gfroerli/hardware/README.md

## PCB

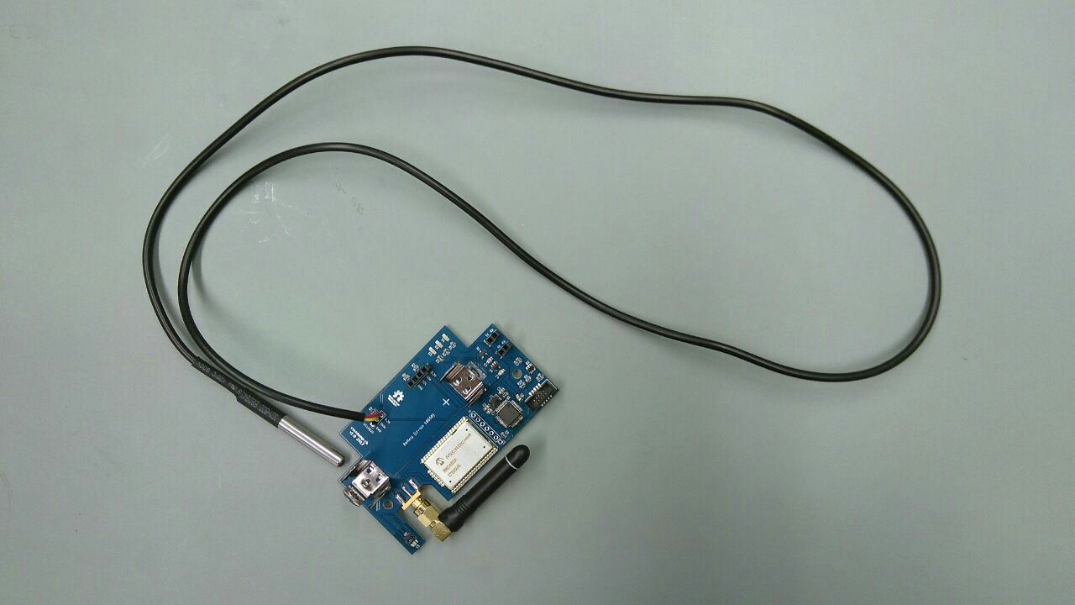
[picture p1: pcb.png]


## Datasheets

- Enclosure: http://www.produktinfo.conrad.com/datenblaetter/525000-549999/536028-da-01-de-GEHAEUSE_ABS_PICCOLO_ABS_B_65_G.pdf
