gfroerli/hardware/pcb/bom.ods

Designators | Value | Size | Digikey | Manufacturer | Quantity
C5,C6,C7 | 100nF | 0805 | 1276-6468-1-ND | CL21B104KBFNNNG | 3
C3,C4 | 1uF | 0805 | 1276-6471-1-ND | CL21B105KOFNNNG | 2
C1,C2 | 18pF | 0805 | 1276-1107-1-ND | CL21C180JBANNNC | 2
R1,R2,R3 | 470Ohm | 0805 | 311-470CRCT-ND | RC0805FR-07470RL | 3
R4,R5,R6,R7,R11,R12 | 10kOhm | 0805 | 311-10KARCT-ND | RC0805JR-0710KL | 6
R8 | 4.7kOhm | 0805 | 311-4.70KCRCT-ND | RC0805FR-074K7L | 1
R9 | 6.04kOhm |  | P20683CT-ND | ERJ-PB6B6041V | 1
R10 | 9.31kOhm |  | YAG2002CT-ND | RT0805BRD079K31L | 1
D1 | LED rot | 0805 | 475-1278-1-ND | LS R976-NR-1 | 1
D3 | LED grün | 0805 | 475-1410-1-ND | LG R971-KN-1 | 1
D2 | LED gelb | 0805 | 475-2560-1-ND | LY R976-PS-36 | 1
BT1 | Battery clips |  | 36-54-ND | Digikey 36-54-ND | 1
U1 | uC | 48LQFP | 68-8460-ND | LPC11U24FBD48/401 | 1
Y1 | Crystal 12MHz |  | 535-10901-1-ND | ABM8G-12.000MHZ-4Y-T3 | 1
Q1 | PMOS |  | SSM3J338RLFCT-ND | SSM3J338R,LF | 1
U4 | LP5907-Q1 |  | 296-40365-1-ND | LP5907QMFX-3.3Q1 | 1
Q2 | NMOS/PMOS dual |  | DMC2038LVT-7DICT-ND | DMC2038LVT-7 | 1
AE1 | SMA connector | edge mount 1.6mm | j502-ND | 142-0701-801 | 1
U2 | RN2483 |  | RN2483A-I/RM103-ND | RN2483A-I/RM103 | 1
U3 | SHT21 |  |  |  | 1
J1 | Pin Header | 7pin | S7005-ND | PPTC071LFBN-RC | 1
J3 | Pin Header | 4pin | S7002-ND | PPTC041LFBN-RC | 1
J4,J5 | Pin Header | 2pin | S7000-ND | PPTC021LFBN-RC | 2
J2 | SWD Header |  | 1175-1629-ND | CNC Tech 3220-10-0300-00 | 1
 |  |  |  |  | 36
