gfroerli/hardware/schema-v1.pdf

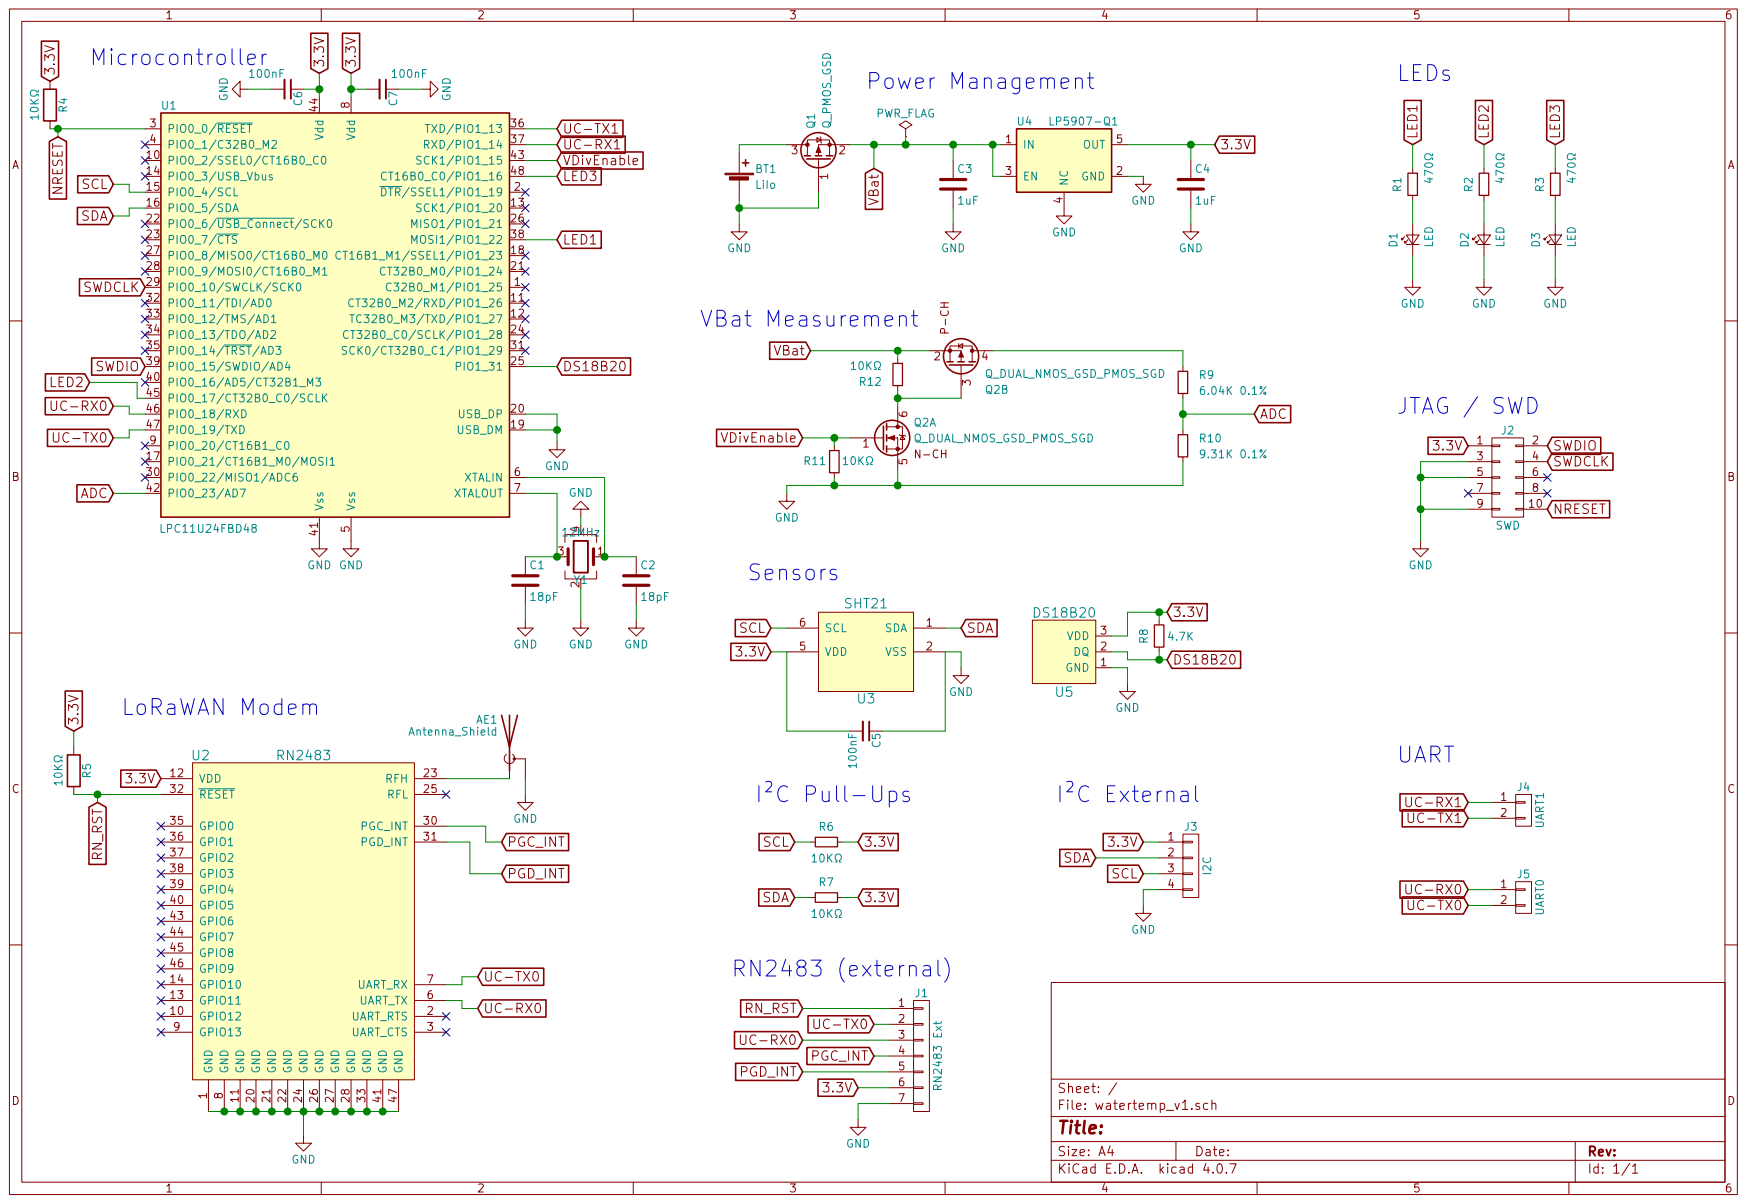
[picture p2: page 1]
