gfroerli/hardware/pcb/watertemp_v1.kicad_pcb

## KiCad design pcb/watertemp_v1.kicad_pcb (2017-11-26)

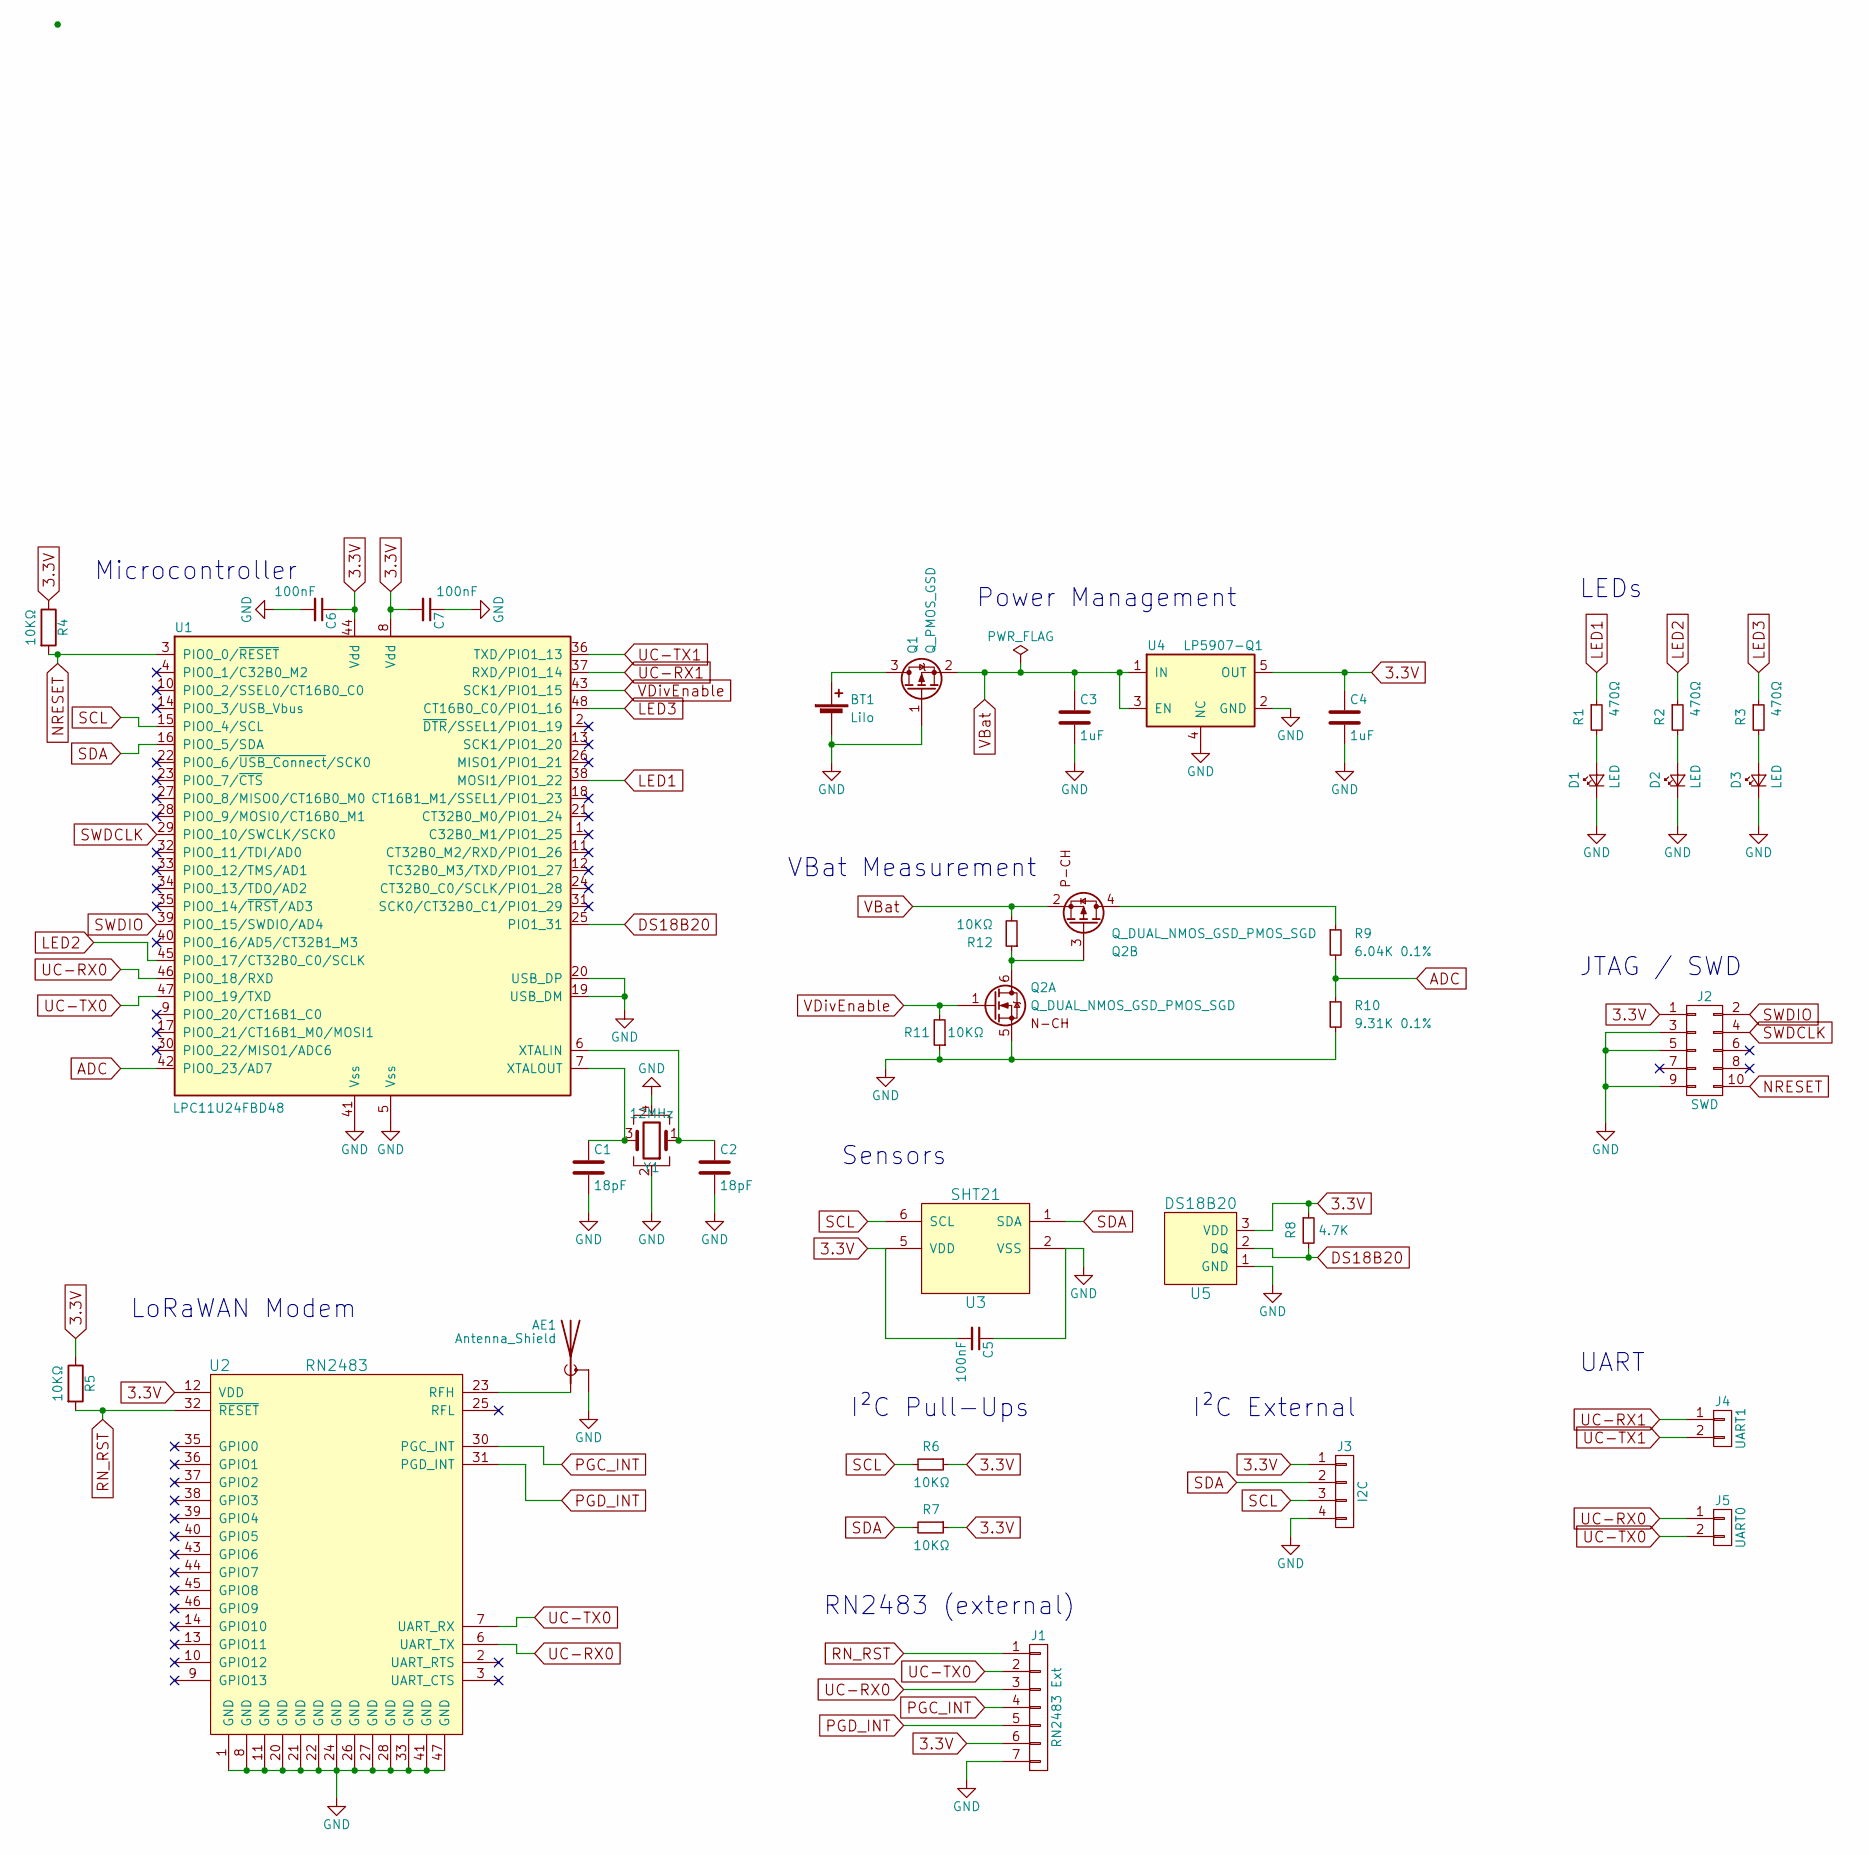
[picture p3: schematic watertemp_v1.sch]

Parts:
AE1: Antenna_Shield; SMA_EDGE; Digikey J502-ND
BT1: LiIo; 36-54-ND; Digikey 36-54-ND
C1, C2: 18pF; C_0805; Part Samsung CL21C180JBANNNC; Digikey 1276-1107-1-ND
C3: 1uF; C_0805; Part Samsung CL21B105KOFNNNG; Digikey 1276-6471-1-ND
C4: 1uF; C_0805; Part Samsung Samsung CL21B105KOFNNNG; Digikey 1276-6471-1-ND
C5: 100nF; C_0805_HandSoldering; Digikey 1276-6468-1-ND
C6, C7: 100nF; C_0805; Digikey 1276-6468-1-ND
D1: LED; LED_0805; Digikey 475-1278-1-ND
D2: LED; LED_0805; Digikey 475-2560-1-ND
D3: LED; LED_0805; Digikey 475-1410-1-ND
J1: RN2483 Ext; Pin_Header_Straight_1x07_Pitch2.54mm
J2: SWD; SWD_10Pin; Digikey 1175-1629-ND
J3: I2C; Pin_Header_Straight_1x04_Pitch2.54mm
J4: UART1; Pin_Header_Straight_1x02_Pitch2.54mm
J5: UART0; Pin_Header_Straight_1x02_Pitch2.54mm
Q1: Q_PMOS_GSD; SOT-23; Digikey SSM3J338RLFCT-ND
Q2: Q_DUAL_NMOS_GSD_PMOS_SGD; TSOT26; Digikey DMC2038LVT-7DICT-ND
R1, R2, R3: 470Ω; R_0805; Digikey 311-470CRCT-ND
R4, R5, R6, R7, R11, R12: 10KΩ; R_0805; Digikey 311-10KARCT-ND
R8: 4.7K; R_0805; Digikey 311-4.70KCRCT-ND
R9: 6.04K 0.1%; R_0805; Digikey P20683CT-ND
R10: 9.31K 0.1%; R_0805; Digikey YAG2002CT-ND
U1: LPC11U24FBD48; LQFP-48_7x7mm_Pitch0.5mm; Digikey 568-8460-ND
U2: RN2483; DigiKey RN2483A-I/RM103-ND
U3: SHT21
U4: LP5907-Q1; SOT-23-5; Digikey 296-40365-1-ND
U5: DS18B20; Pin_Header_Straight_1x03_Pitch2.54mm
Y1: 12MHz; Crystal_SMD_Abracon_ABM8G-4pin_3.2x2.5mm; Part ABM8G-12.000MHZ-4Y-T3; Digikey 535-10901-1-ND

Connections:
3.3V: C4.1, C5.2, C6.1, C7.2, J1.6, J2.1, J3.1, R4.1, R5.1, R6.1, R7.1, R8.1, U1.8 (Vdd), U1.44 (Vdd), U2.12 (VDD), U3.5 (VDD), U4.5 (OUT), U5.3 (VDD)
ADC: R9.2, R10.1, U1.42 (PIO0_23/AD7)
DS18B20: R8.2, U1.25 (PIO1_31), U5.2 (DQ)
GND: AE1.2 (Shield), BT1.2 (-), C1.2, C2.2, C3.2, C4.2, C5.1, C6.2, C7.1, D1.1 (K), D2.1 (K), D3.1 (K), J1.7, J2.3, J2.5, J2.9, J3.4, Q1.1 (G), Q2.5 (S1), R10.2, R11.1, U1.5 (Vss), U1.19 (USB_DM), U1.20 (USB_DP), U1.41 (Vss), U2.1 (GND), U2.8 (GND), U2.11 (GND), U2.20 (GND), U2.21 (GND), U2.22 (GND), U2.24 (GND), U2.26 (GND), U2.27 (GND), U2.28 (GND), U2.33 (GND), U2.41 (GND), U2.47 (GND), U3.2 (VSS), U4.2 (GND), U4.4 (NC), U5.1 (GND), Y1.2, Y1.4
LED1: R1.1, U1.38 (MOSI1/PIO1_22)
LED2: R2.1, U1.45 (PIO0_17/CT32B0_C0/SCLK)
LED3: R3.1, U1.48 (CT16B0_C0/PIO1_16)
NRESET: J2.10, R4.2, U1.3 (PIO0_0/~RESET)
unnamed: AE1.1 (A), U2.23 (RFH)
unnamed: BT1.1 (+), Q1.3 (D)
unnamed: C1.1, U1.7 (XTALOUT), Y1.3
unnamed: C2.1, U1.6 (XTALIN), Y1.1
unnamed: D1.2 (A), R1.2
unnamed: D2.2 (A), R2.2
unnamed: D3.2 (A), R3.2
unnamed: Q2.3 (G2), Q2.6 (D1), R12.1
unnamed: Q2.4 (D2), R9.1
PGC_INT: J1.4, U2.30 (PGC_INT)
PGD_INT: J1.5, U2.31 (PGD_INT)
RN_RST: J1.1, R5.2, U2.32 (~RESET)
SCL: J3.3, R6.2, U1.15 (PIO0_4/SCL), U3.6 (SCL)
SDA: J3.2, R7.2, U1.16 (PIO0_5/SDA), U3.1 (SDA)
SWDCLK: J2.4, U1.29 (PIO0_10/SWCLK/SCK0)
SWDIO: J2.2, U1.39 (PIO0_15/SWDIO/AD4)
UC-RX0: J1.3, J5.1, U1.46 (PIO0_18/RXD), U2.6 (UART_TX)
UC-RX1: J4.1, U1.37 (RXD/PIO1_14)
UC-TX0: J1.2, J5.2, U1.47 (PIO0_19/TXD), U2.7 (UART_RX)
UC-TX1: J4.2, U1.36 (TXD/PIO1_13)
VBat: C3.1, Q1.2 (S), Q2.2 (S2), R12.2, U4.1 (IN), U4.3 (EN)
VDivEnable: Q2.1 (G1), R11.2, U1.43 (SCK1/PIO1_15)

Notes on the sheet:
Power Management
Microcontroller
LoRaWAN Modem
Sensors
JTAG / SWD
LEDs
I²C Pull-Ups
I²C External
UART
RN2483 (external)
VBat Measurement

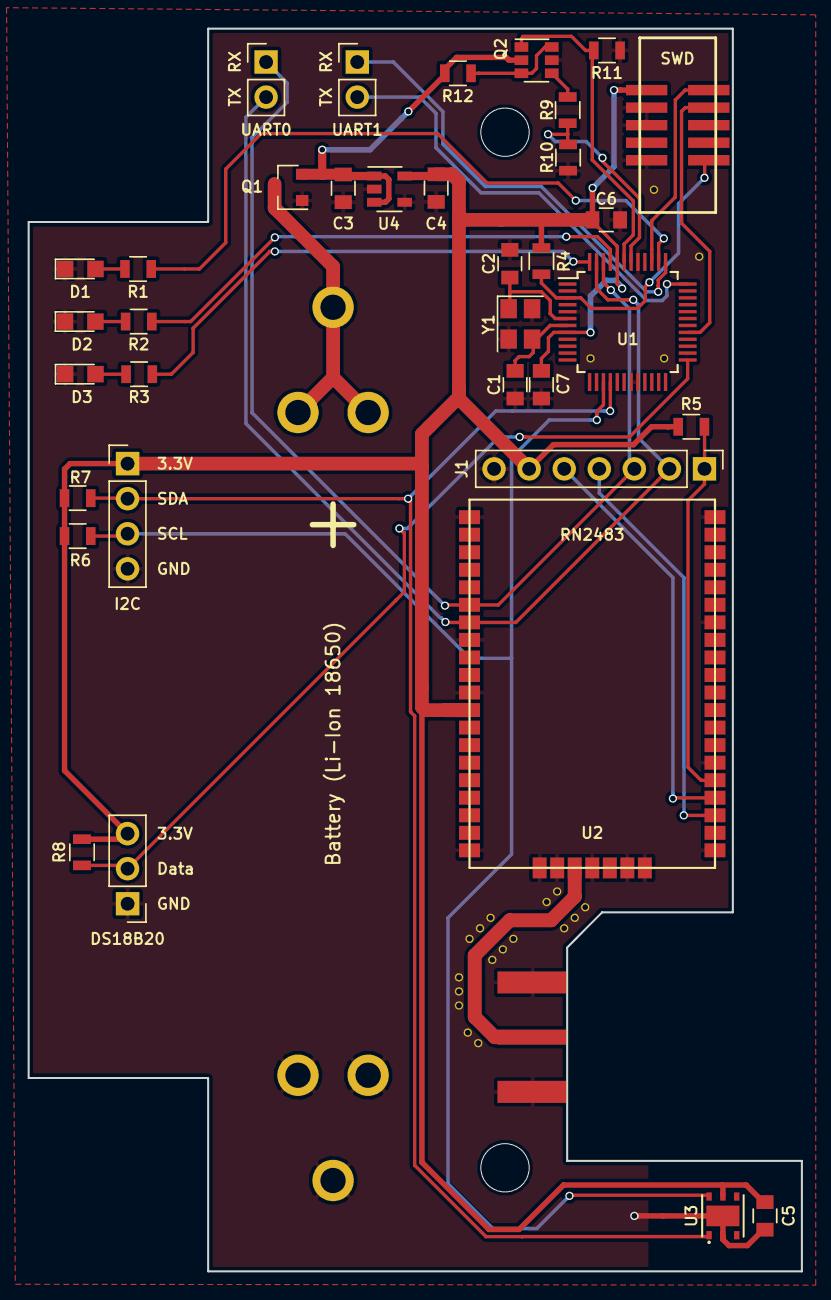
[picture p4: board watertemp_v1.kicad_pcb from above]

Board: 2 copper layers, 56.0 x 90.0 mm, 37 parts (0 on the bottom side), 30 nets.
