gfroerli/hardware/(threads)

Thread 2 (2017-08-15):

SWD footprint

dbrgn, 2017-08-15:
The SWD connector footprint looks very hard to hand-solder. The pads should probably be longer.

([The connector](https://www.digikey.ch/products/de?keywords=1175-1629-ND) should be solderable in the oven though, it's made from polyamide PA6T with a melting point of [320°C](http://www.prochase.com/6t-pa6t.htm) and Nylon 6T with a melting point of [370°C](http://cameo.mfa.org/wiki/Nylon_6T). But it would probably be good to be able to rework this stuff by hand, right @rnestler?)

Closed 2017-10-05.

Thread 3 (2017-08-15):

Verify that SWD connector is correct

dbrgn, 2017-08-15:
@rnestler could you check this?

dbrgn, 2017-11-07:
To quote @rnestler: "I already checked this a few times" 😀

rnestler, 2017-11-09:
> To quote @rnestler: "I already checked this a few times" :grinning:

It's so much work to comment here :wink: Also even if we fucked it up we could still create an adapter.

Closed 2017-11-07.

Thread 4 (2017-08-15):

Add battery meter

dbrgn, 2017-08-15:
A battery meter would be really useful to track the battery voltage. (Maybe a regular ADC would be enough, but I think there are specialized chips for that.)

@rnestler do you think this should go into the first prototype? Do you have experience with these things?

rnestler, 2017-08-17:
> @rnestler do you think this should go into the first prototype? Do you have experience with these things?

I don't really have experience with this things. Also we have a Lio battery with a charging circuit and everything included, so maybe it can even provide this information?

An easy thing to do is just log the voltage of the battery.

dbrgn, 2017-08-17:
> with a charging circuit and everything included

It's only a protection circuit, it doesn't do battery level measuring. (There's no data wire attached :slightly_smiling_face:)

> An easy thing to do is just log the voltage of the battery, although the value of that is pretty low since Lio batteries have a flat charge/voltage curve.

Yes, that would be possible. Our microcontroller probably has a built-in ADC, right?

On the other hand, getting a percentage/charge value would be pretty nice. What about these that provide battery voltage / charge / temperature monitoring?

- [STC3100IST](https://www.digikey.com/product-detail/en/stmicroelectronics/STC3100IST/497-10526-1-ND/2270946) (1uA in power down, 100uA when operating)
- [TI bq27441-G1](https://www.digikey.com/product-detail/en/texas-instruments/BQ27441DRZR-G1A/296-39941-1-ND/5177818) (9uA in hibernate mode, 93uA when operating)
- [LC709203F](https://www.digikey.com/product-detail/en/on-semiconductor/LC709203FQH-01TWG/LC709203FQH-01TWGOSCT-ND/5801645) (3uA when operating)

If I understand it correctly, these chips must be always on, so 100uA / 93uA is way too much in our case, right? Or can they also be operated in sleep mode?

What about the third option?

rnestler, 2017-08-17:
>  LC709203F (3uA when operating)

I'm not sure if we can handle that one, it's [MSL](https://en.wikipedia.org/wiki/Moisture_sensitivity_level) 3 (168 Hours). So we can't keep it for longer than 168 hours before soldering...

dbrgn, 2017-08-17:
I see. But that's fine if we keep it in the original packaging until when we solder the boards, right?

rnestler, 2017-08-17:
>If I understand it correctly, these chips must be always on, so 100uA / 93uA is way too much in our case, right? Or can they also be operated in sleep mode?

I think you understand correctly. The main problem is, that those IC's are designed for smart-phones and other portable devices, which have a rather high current usage and get charged quite often.

dbrgn, 2017-08-17:
Hm, let's go with voltage measurements for now to keep it simple. That should be easy with the ADC, right?

The built-in 10 bit ADC supports the voltage range 0V-VDD. Since we get 3.3V from the LDO, we'd need voltage dividing resistors, correct?

rnestler, 2017-08-17:
> The built-in 10 bit ADC supports the voltage range 0V-VDD. Since we get 3.3V from the LDO, we'd need voltage dividing resistors, correct?

Correct!

dbrgn, 2017-08-22:
Hm, the voltage divider also uses up current. @rnestler can you ask at work whether they have experience with this kind of problem?

dbrgn, 2017-08-22:
Here's a potential solution with a transistor and a P-channel MOSFET: https://electronics.stackexchange.com/questions/64490/low-current-battery-monitoring#64491

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

What about that?

rnestler, 2017-08-23:
Isn't it possible to do it simpler? Just use an N-MOSFET to connect the voltage divider to GND? Or is the ADC input leakage to big?

dbrgn, 2017-08-23:
There are two comments on that answer regarding that:

> @jme - the ADC and MCU is referenced to ground and so it makes sense to switch the higher voltage feed. If I used an N channel device there would still be a drain permanently through the top resistor and thru the parasitic diodes in the MCU when it is in sleep mode.

> "Why not use a low side switch (e.g. N-ch FET or μC i/o pin)?" is a good question. Here's why. The battery voltage can be greater than Vcc. When the low side switch is opened, then the battery voltage will appear on the A/D pin. That could lead to the burnage of the A/D, or to a leakage of the battery through the protection diodes on the A/D pin.

I don't fully understand them though :)

rnestler, 2017-08-23:
Ah of course, silly me. If we disable the voltage divider the ADC input will be at battery voltage, which may or may not damage it, but certainly lead to a current flowing through the ESD diode to VDD.

dbrgn, 2017-08-23:
Ok, the schematic up there is a bit complex, but probably worth it. What do you think @rnestler? This should reduce the power requirements to the leak current of the FET and the BJT.

dbrgn, 2017-08-25:
What about this one?

https://www.digikey.ch/products/de?keywords=MAX6430EGUS%2BT-ND

It's a very simple dual-level voltage monitoring chip. This one (MAX6430EGUS) is factory-fixed to signal low_H at 3.3V and low_L at 3.0V and uses active push-pull for signal indication. (Open drain variants also exist but aren't available on Digikey.) It could be used to send a warning message / add a warning flag below 3.3V and turn off the circuit at 3.0V. (There are also user-configurable versions, but those would require external resistors.)

If you look at the voltage curve of a typical high capacity 18650 cell, it looks like this:

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

With low current consumption, at 3.3V, 3000 mAh have already been consumed. At 3.0V, additional 250 mAh have been consumed.

I think this could be a good alternative to the voltage divider, since it only requires a single part, no external components, and also turns off the entire circuit below a certain voltage. This would allow us to use unprotected Li-Ion cells, which are shorter and cheaper. Price is quite high though, at 4.40 CHF per piece when buying 10.

Downside when not having a voltage divider is that we don't know the voltage at all. We could also do both.

dbrgn, 2017-08-25:
Something like this, right @rnestler?

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

dbrgn, 2017-10-19:
Ping @rnestler. Maybe @ubruhin also wants to take a look?

ubruhin, 2017-10-20:
I guess your circuit does not work as expected. The voltage level of `LBOL` is referenced to the negative battery pin, but the voltage at the gate pin of the mosfet needs to be referenced to GND (which is *not* equal to the negative battery pin, it's floating as long as the mosfet is not yet switched on).

dbrgn, 2017-10-23:
We'll use the voltage divider and a DMC2038LVT-7DICT-ND dual MOSFET.

dbrgn, 2017-11-06:
Does this look good to you, @rnestler @ubruhin?

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

[Simulation at 5.2V](http://www.falstad.com/circuit/circuitjs.html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):

Disabled: 104 nA

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

Enabled: 1.4 mA

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

[Simulation at 3.3V](http://www.falstad.com/circuit/circuitjs.html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)

Disabled: 66 nA

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

Enabled: 873 uA

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

Total resistance: 15.34 kOhm.

The ADC reference is Vdd and we have 3.3V output from the LDO, so below that voltage we won't get usable results anymore (since the reference drops too). But that will only happen at the very end of the battery lifetime.

Thread 7 (2017-08-17):

RN2483 ICSP Protection

dbrgn, 2017-08-17:
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

Do we need something like that?

dbrgn, 2017-10-19:
@rnestler ping :)

rnestler, 2017-10-23:
Maybe we could just add a solder bridge?

rnestler, 2017-10-23:
> The  normal  firmware  upgrade  method  is  through  the
internal  bootloader  of  the  module  via  the  UART.
> http://ww1.microchip.com/downloads/en/DeviceDoc/50002346C.pdf

So this would be highly unlikely that we ever need it. So a solder bridge between RN_RST and the pull-up resistor would definitely be enough.

dbrgn, 2017-11-06:
A solder bridge is a bit annoying if we have to add it for every board.

If we ever need to use ICSP, we can simply desolder the pull-up, that'll result in the same thing.

Closed 2017-11-06.

Thread 8 (2017-08-17):

Programming the RN2483

dbrgn, 2017-08-17:
Seems that it would be possible to program the RN2483 directly?

https://www.thethingsnetwork.org/forum/t/microchip-released-rn2483-library-code/4439

Would that suffice for our use case? It wouldn't be mbed compatible anymore though.

rnestler, 2017-08-17:
> The documentation states loading your own firmware on the module invalidates the certification.

From the linked forum. Is this a problem for us?

dbrgn, 2017-08-17:
Nope, as long as we don't sell our sensors as LoRaWAN certified devices :)

dbrgn, 2017-08-17:
The question is rather whether we have some significant limitations that we don't want to accept. With an external MCU we're probably more flexible.

dbrgn, 2017-10-19:
@rnestler we should probably stick to the external MCU, right?

rnestler, 2017-10-23:
For the moment yes.

Closed 2017-10-23.

Thread 10 (2017-08-21):

Oscillator footprint mapping seems wrong

rnestler, 2017-08-21:
If read the datasheet correctly, pad 2 and 4 should be GND and 1 and 3 for the oscillator.

Probably we should change the schematic symbol as well.

Closed 2017-09-18.

Thread 11 (2017-08-21):

Reverse polarity protection for the power supply

rnestler, 2017-08-21:
Should we add a diode as a protection for a reversed battery?

dbrgn, 2017-09-18:
We could use a P-FET circuit with this one: https://www.digikey.ch/products/de?keywords=SSM3J338RLFCT-ND

Closed 2017-09-18.

Thread 12 (2017-11-07):

DS18B20 pull up resistor value

rnestler, 2017-11-07:
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
Do we need such a low resistance pull-up? (power consumtion...)

But this is a minor issue, since it doesn't influence the PCB. We can change it later.

dbrgn, 2017-11-07:
That's the pull-up suggested by the DS18B20 datasheet, IIRC.

dbrgn, 2017-11-21:
@rnestler should we stick with it?

Thread 13 (2017-11-07):

Remove J5 in next version

dbrgn, 2017-11-07:
The first version has J5 connected to UART0 which is a bit redundant since we can also access UART0 through J1. Remove it in the next version.

rnestler, 2019-06-15:
I'm not sure if we want a separate connector which is compatible with the debug UART or not. IMO it doesn't really hurt to have it.

dbrgn, 2019-06-15:
I'd remove it, it also makes it less probable that you accidentally connect to the wrong one.

Thread 14 (2017-11-18):

SMA connector in stencil mask

rnestler, 2017-11-18:
Currently the SMA connector pads are in the stencil mask. Since we can't really re-flow solder it we should remove them.

rnestler, 2019-06-15:
Integrated in https://github.com/gfroerli/hardware-v2/issues/6.

Closed 2019-06-15.

Thread 15 (2017-11-18):

Connector for Power

rnestler, 2017-11-18:
In a lab environment it's more practical to use a bench-top power supply than a battery.

dbrgn, 2017-11-18:
What type of connector should we use? JST micro connector, something [like this](https://www.digikey.ch/products/de?keywords=455-1734-1-ND)?

dbrgn, 2018-01-30:
Maybe both USB and a 2 pin header?

Thread 16 (2017-11-20):

Add hardware version detection

rnestler, 2017-11-20:
We are the worst... we forgot to add hardware detection 😄

dbrgn, 2017-11-21:
Good point 😉

How is this usually being done, with some kind of ID chip or ROM?

rnestler, 2017-11-22:
Way to complicated 😉 Just pull some pins to GND.

ubruhin, 2017-11-22:
Or two resistors as voltage divider connected to an ADC pin.

rnestler, 2017-11-22:
> Or two resistors as voltage divider connected to an ADC pin.

Then there must flow current, which is not nice for a low power device. When pulling to GND we can just disable the internal pull-ups after reading the version.

rnestler, 2017-11-22:
Here is an example of what I mean:
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

dbrgn, 2017-11-23:
Sure, why not :)

Thread 17 (2017-11-21):

SMA footprint: Bottom copper

dbrgn, 2017-11-21:
Right now the soldermask seems to go over the bottom copper pads. Might be a manufacturing issue, or a bug in the footprint itself.

rnestler, 2017-11-22:
Related to #14

rnestler, 2019-06-15:
Integrated in https://github.com/gfroerli/hardware-v2/issues/6.

Closed 2019-06-15.

Thread 18 (2017-11-21):

Connect RN2483 to UART1

dbrgn, 2017-11-21:
Right now it's connected to UART0 which is also used by mbed for `printf`.

dbrgn, 2017-11-21:
Related: #13

dbrgn, 2019-06-14:
Obsolete in v2.

Closed 2019-06-14.

Thread 19 (2017-11-22):

Better silkscreen

dbrgn, 2017-11-22:
Some stuff (e.g. orientation) is missing...

dbrgn, 2019-06-14:
Will be better in v2 thanks to LibrePCB.

Closed 2019-06-14.

Thread 20 (2017-12-29):

Add GND pin to the UART connectors

rnestler, 2017-12-29:
If using UART one always also needs a GND pin for reference. It's annoying if GND needs to come from another connector.

rnestler, 2019-06-15:
Done in hardware-v2.

Closed 2019-06-15.

Thread 21 (2018-01-15):

Larger NPTH

dbrgn, 2018-01-15:
The holes for the screws are quite tight.

Also, distance from parts is not too large.

Thread 23 (2018-06-05):

Replace SHT21 with SHTC3

rnestler, 2018-06-05:
Smaller, lower power usage and cheaper :smiley:

dbrgn, 2019-06-14:
Fixed in v2.

Closed 2019-06-14.

Thread 24 (2018-08-21):

Re-evaluate MCU

dbrgn, 2018-08-21:
What if we'd switch to an STM32F1 or similar for better Rust support, @rnestler?

rnestler, 2018-08-22:
> What if we'd switch to an STM32F1 or similar for better Rust support, @rnestler?

Would probably be a lot easier :wink: On the other hand we could just implement the stuff we need in https://github.com/coredump-ch/lpc11uxx-hal-rs.

dbrgn, 2018-08-22:
Yeah, would also be interesting. But also quite tricky to do correctly. See the [Rx](https://japaric.github.io/stm32f103xx-hal/src/stm32f103xx_hal/serial.rs.html#199) implementation for example... I would never have thought of the sequential memory ordering barrier.

rnestler, 2019-05-14:
https://www.digikey.ch/product-detail/de/stmicroelectronics/STM32L071KBT6/497-18577-ND/6166986 could be a good candidate. There are already a few crates around which should support it: https://crates.io/search?q=stm32l0

dbrgn, 2019-06-14:
We're using the STM32L071KBT6.

Closed 2019-06-14.

Thread 26 (2019-05-17):

Connect BOOT0 pin

dbrgn, 2019-05-17:
On the STM32L0, make sure to connect the BOOT0 pin so it doesn't float.

From the [reference manual](https://www.st.com/content/ccc/resource/technical/document/reference_manual/21/bd/0f/bd/1c/88/40/f0/DM00108282.pdf/files/DM00108282.pdf/jcr:content/translations/en.D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):

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

From IRC:

```
14:24 < therealprof1> dbrgn: Yeah, there's some weird quirks and error modes for some
                      of the chips. Is this a Nucleo board or some custom hardware?
14:25 < therealprof1> In case the latter, I'd recommend checking out the BOOT pin(s),
                      if they're floating in the breeze you'll experience fancy
                      random errors every now and then.
```
