gfroerli/hardware/(commit log)

2017-06-21 Import from coredump-ch/watertemp repo
    [watertemp_v1.kicad_pcb, watertemp_v1.sch]
2017-06-21 Start BOM
    [bom.csv]
2017-07-22 Add LEDs
    [watertemp_v1.sch]
2017-07-22 Add I²C connector and pull-ups
    [watertemp_v1.sch]
2017-07-22 Add UART debug pins
    [watertemp_v1.sch]
2017-07-22 Add connector for external RN2483 board
    [watertemp_v1.sch]
2017-07-22 Expose RN2483 ICSP header
    [watertemp_v1.sch]
2017-07-22 Reorganize schematics
    [watertemp_v1.sch]
2017-07-24 Finish parts selection
    - Replace 20 pin JTAG connector with 10 pin SWD connector
    - Choose footprints for all parts
    [watertemp_v1.sch]
2017-07-24 Expose both UARTs
    [watertemp_v1.sch]
2017-08-15 Continue work on PCB
    [watertemp_v1.kicad_pcb, watertemp_v1.sch]
2017-08-15 Finish routing first version
    [watertemp_v1.kicad_pcb, watertemp_v1.sch]
2017-08-15 Some more details
    [watertemp_v1.kicad_pcb]
2017-08-16 Enlarge some of the pads for hand soldering
    [watertemp_v1.kicad_pcb, watertemp_v1.sch]
2017-08-16 Add OSHW and Coredump logos (fixes #5)
    [watertemp_v1.kicad_pcb]
2017-08-21 Add LDO Digikey part number
    [watertemp_v1.sch]
2017-09-18 Add reverse polarity protection (fixes #11)
    [watertemp_v1.kicad_pcb, watertemp_v1.sch]
2017-09-18 Add more stitching vias (fixes #6)
    [watertemp_v1.kicad_pcb]
2017-09-18 Fix oscillator symbol/footprint (fixes #10)
    [watertemp_v1.kicad_pcb, watertemp_v1.sch]
2017-09-18 Move oscillator closer µC
    [watertemp_v1.kicad_pcb]
2017-10-05 Add silkscreen labels to UART headers (fixes #1)
    [watertemp_v1.kicad_pcb, watertemp_v1.sch]
2017-10-05 Make SWD footprint pads larger (fixes #2)
    [watertemp_v1.kicad_pcb]
2017-10-05 Fix problems with LDO
    - Use SOT-23-5 footprint (fixes #9)
    - Connect EN to IN
    - Connect pin 4 (NC) to GND as recommended in the
    datasheet (section 11.2)
    [watertemp_v1.kicad_pcb, watertemp_v1.sch]
2017-11-06 Add draft of voltage divider (refs #4)
    [watertemp_v1.sch]
2017-11-06 Connect USB_DM/DP pins to GND
    According to datasheet:
    > If the pins are not used, tie floating pi ns to ground or power to
    > minimize power consumption.
    [watertemp_v1.sch]
2017-11-06 Connect battery meter to µC
    [watertemp_v1.sch]
2017-11-06 Fix stuff by Raphi :D
    [watertemp_v1.sch]
2017-11-06 Add TSOT26 footprint and regenerate netlist
    [watertemp_v1.sch]
2017-11-07 Routing for voltage divider (fixes #4)
    [watertemp_v1.kicad_pcb]
2017-11-07 Increase 3.3 supply line thickness
    [watertemp_v1.kicad_pcb]
2017-11-07 Connect remaining unconnected parts
    [watertemp_v1.kicad_pcb]
2017-11-08 Nicer routing of traces
    [watertemp_v1.kicad_pcb]
2017-11-08 More routing and silkscreen optimizations
    [watertemp_v1.kicad_pcb]
2017-11-13 Add Digikey part number to RN248
    [watertemp_v1.sch]
2017-11-13 Add order numbers to schema elements
    [watertemp_v1.sch]
2017-11-18 Improve fabrication layer
    [watertemp_v1.kicad_pcb]
2017-11-20 Add BOM table
    [bom.csv, bom.ods]
2017-11-20 Expand BOM with manufacturer no and designators
    [bom.ods]
2017-11-21 Update PCB photo
2017-11-26 Improve R6/R7 placing
    [watertemp_v1.kicad_pcb]
2017-12-05 Add schematics PDF
